CandleSir/pineapplepager-cooling-dock/src/lib.scad

// Everything except top-level geometry; tests and dock.scad include this.
include <params.scad>
include <pager.scad>
include <fan.scad>
include <body.scad>
include <filter.scad>
