CandleSir/pineapplepager-cooling-dock/(list of files, cad)

Other CAD files:
hak5-wifi-pineapple-pager.step
stl/dock-60x25.stl
stl/fan-gauge-60x25.stl
stl/fan-gauge-60x15.stl
stl/fan-gauge-40x20.stl
stl/dock-40x20.stl
stl/dock-40x10.stl
stl/fan-gauge-40x10.stl
stl/dock-60x15.stl
stl/filter-grid-60.stl
stl/filter-grid-40.stl
stl/coupon.stl
stl/filter-cap-40.stl
stl/filter-cap-60.stl
stl/fit-gauge.stl
stl/gasket.stl
hak5-wifi-pineapple-pager.stl
