CandleSir/pineapplepager-cooling-dock/(commit log)

2026-10-18 pager reference files
    [hak5-wifi-pineapple-pager.step, hak5-wifi-pineapple-pager.stl]
2026-10-18 chore: track CAD binaries with git lfs
    [hak5-wifi-pineapple-pager.step, hak5-wifi-pineapple-pager.stl]
2026-10-18 feat: pager parameters, pose and test harness
    [body.scad, dock.scad, lib.scad, pager.scad, params.scad]
2026-10-18 feat: trapezoid body with tilted drop-in fan slot
    [body.scad, fan.scad, params.scad]
2026-10-18 feat: drop-in pager seat with clip relief and port window
    [body.scad, pager.scad, params.scad]
2026-10-18 feat: sealed plenum, intake duct and isolated exhaust
    [body.scad, params.scad]
2026-10-18 feat: cable management, fit coupon and tpu gasket
    [body.scad, params.scad]
2026-10-18 feat: export 80/92/120 variants, previews and readme
    [body.scad, coupon-120.stl, coupon-80.stl, coupon-92.stl, dock-120.stl, dock-80.stl, dock-92.stl, gasket-120.stl]
2026-10-18 fix: seal 80 mm plenum, gasket groove walls, wider button notch
    [body.scad, coupon-120.stl, coupon-80.stl, coupon-92.stl, dock-120.stl, dock-80.stl, dock-92.stl, params.scad]
2026-10-18 docs: optional screw-on noctua grill; test grill fits either fan face
2026-10-18 feat: tighter top wall (seat_clear_top 0.15) and 7 g fit gauge
    Coupon 1: ends and depth fit; ~1 mm play across the width, all of it the
    designed clearance. Gravity seats the pager on the -Y seal wall, so only the
    +Y wall moves in; vent alignment and the seal are unchanged. env_grow 0.3 ->
    0.1 (reference mesh sits exactly on pg_W; the coupon confirmed it).
    [body.scad, coupon-120.stl, coupon-80.stl, coupon-92.stl, dock-120.stl, dock-80.stl, dock-92.stl, dock.scad]
2026-10-18 fix: designed-in supports so the dock prints with supports off
    Bambu Studio flagged a cantilever at the top of the fan tray. The angle-only
    overhang test missed edges that hang with nothing beneath them: the ledge strip
    above the fan air opening (66/78 mm bridge on 80/92) and the lowest edge of the
    belt-clip pocket wall (72-83 mm). Ribs (1.2 mm) split the air opening and posts
    (1.2 x 2.4 mm) hold up the clip wall; longest bridge now 23.5 mm, +0.7-1.6 g.
    test_no_long_bridges replaces test_no_trapped_supports.
    [body.scad, dock-120.stl, dock-80.stl, dock-92.stl, params.scad]
2026-10-19 docs: v0.2 design (small fans, tapered back, dust filter)
2026-10-19 feat(v0.2): tilted fan frame placed behind the seat cuts
    [body.scad, fan.scad, params.scad]
2026-10-19 feat(v0.2): tapered body and drop-in tilted fan slot with teardrop hole
    [body.scad, params.scad]
2026-10-19 feat(v0.2): small chamber from the fan hole to the intake
    [body.scad]
2026-10-19 feat(v0.2): snap-together filter frames and fan-slot gauge
    [body.scad, dock.scad, filter.scad, lib.scad]
2026-10-19 build(v0.2): 60/40 variants, filter frames, gauges; readme
    [coupon-120.stl, coupon-80.stl, coupon-92.stl, coupon.stl, dock-120.stl, dock-40x10.stl, dock-40x20.stl, dock-60x15.stl]
2026-10-19 fix(v0.2): finger scallops, press-fit filter pegs, bottom-edge cable only
    Final review: fan and filter had nothing to grip; filter pegs were a loose
    clearance fit; side-edge cable poses fit seated but couldn't drop in (grooves
    for them freed the fan sideways, so only bottom-edge exits are supported).
    README filter install order fixed (fan first, stack behind it).
    [body.scad, coupon.stl, dock-40x10.stl, dock-40x20.stl, dock-60x15.stl, dock-60x25.stl, fan-gauge-40.stl, fan-gauge-60.stl]
2026-10-19 fix: fan gauge reaches the side walls above the cable reliefs
    The gauge stopped 12 mm up, below the top of the corner reliefs (15 mm), so it
    showed the 49.6/69.6 mm relief opening instead of the 40.6/60.6 mm fit. Now 8 mm
    of real side wall above the reliefs; test checks the wall is present.
    [body.scad, fan-gauge-40.stl, fan-gauge-60.stl]
2026-10-19 fix: 45 deg roof over the cable reliefs, no flat shelves in slot or gauge
    The taller fan gauge exposed the relief tops: the side wall and rear lips above
    each relief were 4.5 mm flat shelves (15 deg in the dock), so the gauge needed
    supports. A 45 deg roof from the lips' inner edge outward removes them; the
    gauge test now rejects flat shelves over 1 mm.
    [body.scad, dock-40x10.stl, dock-40x20.stl, dock-60x15.stl, dock-60x25.stl, fan-gauge-40.stl, fan-gauge-60.stl]
2026-10-21 docs(v0.3): design: filter slot, floating toe, sloped roof
2026-10-21 feat(v0.3): filter slot behind a divider; fan slot is fan-depth
    [body.scad, fan.scad, params.scad]
2026-10-21 feat(v0.3): fan gauge per variant, slot at fan depth
    [fan-gauge-40.stl, fan-gauge-40x10.stl, fan-gauge-60.stl, fan-gauge-60x25.stl]
2026-10-21 feat(v0.3): floating toe under the front edge
    [body.scad, params.scad]
2026-10-21 feat(v0.3): roof slopes down toward the back, as steep as the fan allows
    [body.scad, coupon.stl, params.scad]
2026-10-21 build(v0.3): parts, previews, readme
    [dock-40x10.stl, dock-40x20.stl, dock-60x15.stl, dock-60x25.stl, fan-gauge-40x10.stl, fan-gauge-40x20.stl, fan-gauge-60x15.stl, filter-grid-40.stl]
2026-10-21 fix(v0.3): cap the divider above the fan; honest filtration wording
    [body.scad, dock-40x10.stl, dock-40x20.stl, dock-60x15.stl, dock-60x25.stl, fan-gauge-40x10.stl, fan-gauge-40x20.stl, fan-gauge-60x15.stl]
